CircuitCo/BeagleBone-DVI-D-with-Audio-RevA/BeagleBone-DVI-D-with-Audio-RevA-bom.xls

 |  | BeagleBone DVI-D with Audio | 2012-07-06
 |  | Rev A
ITM | QTY | REF DESIGNATIORS | PART | DESCRIPTION | MAN | PART # | COMMENT
1 | 25 | C7,C8,C9,C10,C11,C12,C13,C14,C15,C16,C18,C19,C20,C21,C22,C23,C79,C50,C51,C52,C54,C57,C60,C63,C78 | 0.1uF | Capacitor 0.1uF 16V 10% 0402 X7R | Kemet | C0402C104K4RACT
2 | 10 | C1,C2,C3,C4,C17,C55,C56,C58,C59,C62 | 10uF,0805 | CAP CER 10UF 10V Y5V 0805 | TDK | C2012Y5V1A106Z
3 | 2 | C46, C47 | 47uF | CAP CER 47UF 10V X5R 1210 | Murata | GRM32ER61A476KE20L
4 | 4 | C48,C49,C53,C61 | 47pF | CAP CER 47PF 50V C0G 5% 0402 | TDK | C1005C0G1H470J
5 | 4 | D1,D2,D3,D4 | PGB0010603MR | Ferrite Bead 150 Ohm 800mA | Steward | LI0805H151R-10
6 | 2 | D5,D6 | 598-8170-107F | LED Green SMD 20mA 2V 0805 | Dialight | 598-8170-107F
7 | 6 | FB1,FB2,FB3,FB6,FB7,FB8 | IND,MMZ1608R301A | FERRITE CHIP 300 OHM 500MA 0603 | TDK | MMZ1608R301A
8 | 1 | SW1 | 2 POS Dip Switch | SWITCH TAPE SEAL 2 POS SMD | CTS | 219-2MST
9 | 2 | P1,P2 | 2x23 HEADER FEMALE | .100 CL Dual Row- Straight Socket Strip- using .025" Sq. Pins | MLE | SSHQ-123-D-08-G-LF
 |  |  | 2x23 HEADER FEMALE | .100 CL Dual Row- Straight Socket Strip- using .025" Sq. Pins | MLE | SSHQ-123-D-08-F-LF
10 | 1 | P3 | 2x5 HEADER FEMALE | .100 CL Dual Row- Straight Socket Strip- using .025" Sq. Pins | MLE | SSHQ-105-D-08-G-LF
 |  |  | 2x5 HEADER FEMALE | .100 CL Dual Row- Straight Socket Strip- using .025" Sq. Pins | MLE | SSHQ-105-D-08-F-LF
11 | 1 | P4 | CONN_HDMI | CONN RCPT HDMI TYPE A R/A SMD | FCI | 10029449-001RLF
12 | 2 | P6,P7 | PHONOJACK STEREO-R | CONN JACK STEREO 3POS 3.5MM SMD | CUI | SJ1-3513-SMT
13 | 1 | Q1 | DMC56404 | TRANS NPN/NPN W/RES 50V SMINI6 | Panasonic | DMC564040R
14 | 1 | RT1 | PTC_RXEF010 | POLYSWITCH PTC RESET 0.1A | Polyswitch | RXEF010
15 | 20 | R16,R18,R20,R22,R24,R26,R28,R31,R33,R35,R36,R38,R40,R42,R44,R45,R58,R60,R62,R64, | 33402 | RES 33.0 OHM 1/16W 1% 0402 SMD | Yaego | RC0402FR-0733RL
16 | 20 | R37,R39,R41,R43,R52,R54,R59,R63,R65,R66,R69,R70,R74,R75,R76,R77,R78,R79,R80,R81 | 10402 | RES 10.0 OHM 1/16W 1% 0402 SMD | Yaego | RC0402FR-0710RL
17 | 4 | R86,R90,R94,R95,R123 | 10K | Resistor 10Kohm 1/16W 5% 0402 | Rohm | MCR01MZPJ103
18 | 1 | R87 | 510 | RES 510 OHM 1/16W 1% 0402 SMD | Yaego | RC0402FR-07510RL
19 | 2 | R88,R92 | 1.1K | RES 1.10K OHM 1/16W 1% 0402 SMD | Yageo | RC0402FR-071K1L
20 | 5 | R89,R93,R116,R117,R118 | 4.75K | RES 4.75K OHM 1/16W 1% 0402 SMD | Stackpole Electronics | RMCF0402FT4K75
21 | 3 | R108, R109, R110 | 33402 | RES 33.0 OHM 1/16W 1% 0402 SMD | Yaego | RC0805FR-0749R9L
22 | 1 | R112 | 28K | RES 28.0K OHM 1/16W 1% 0402 SMD | Yageo | RC0402FR-0728KL
23 | 1 | R113 | 56.2K | RES 56.2K OHM 1/16W 1% 0402 SMD | Yageo | CRCW040256K2FKED
24 | 1 | R111 | .1,0805 | RES .10 OHM 1/8W 5% 0805 | CTS | 73L3R10J
25 | 2 | R119,R120 | 470,5% | RES 470 OHM 1/10W 5% 0402 SMD | Panasonic | ERJ-2GEJ471X
26 | 2 | R121,R122 | 100K,1% | Resistor 100Kohm 1/16W 1% 0402 | Yageo | CRCW0402100KJNED
27 | 2 | R114,R115 | 5.6K | RES 5.6K OHM 1/16W 5% 0402 SMD | Yaego | RC0402JR-075K6L
28 | 2 | R130, R132 | 0 | Resistor Zero ohm Jumper 0402 | Yageo | RC0402JR-070RL
29 | 1 | U1 | 74AVC32t245 | IC BUS TRANSCVR 32BIT 96BGA | TI | SN74AVC32T245ZKER
30 | 1 | U2 | TFP410 | IC TRANSMITTER DIGITAL 64-HTQFP | TI | TFP410PAP
31 | 1 | U3 | TXS0102DCU | IC VOLT-LEVEL TRANSLATOR 8-US8 | TI | TXS0102DCUR
32 | 1 | U8 | CAT24C256W | IC EEPROM 256KBIT 400KHZ 8SOIC | ON | CAT24C256WI-G
33 | 1 | U6 | TLV320AIC3106 | IC STER AUD CODEC 32 BIT 48-VQFN | TI | TLV320AIC3106IRGZR
34 | 1 | U7 | TPS73701DRBR | IC REG LDO CAP FREE 8-SON | TI | TPS73701DRBR
35 | 1 | Y1 | 12MHz | OSCILLATOR 12.000 MHZ 3.3V SMD | Fox | FXO-HC735-12
 | DNI | R1,R107,R131,R133,C80,U9,C5,C6,C67,C68,C69,C70,C71, C72,C73,C74,C75,C76,C77,C81,R91,R96,R97,R98
