CircuitCo/BeagleBone-DVI-D-with-Audio-RevA/BeagleBone-DVI-D-with-Audio-RevA-schematic.pdf

# 08/14/2012 BBT

# DATE

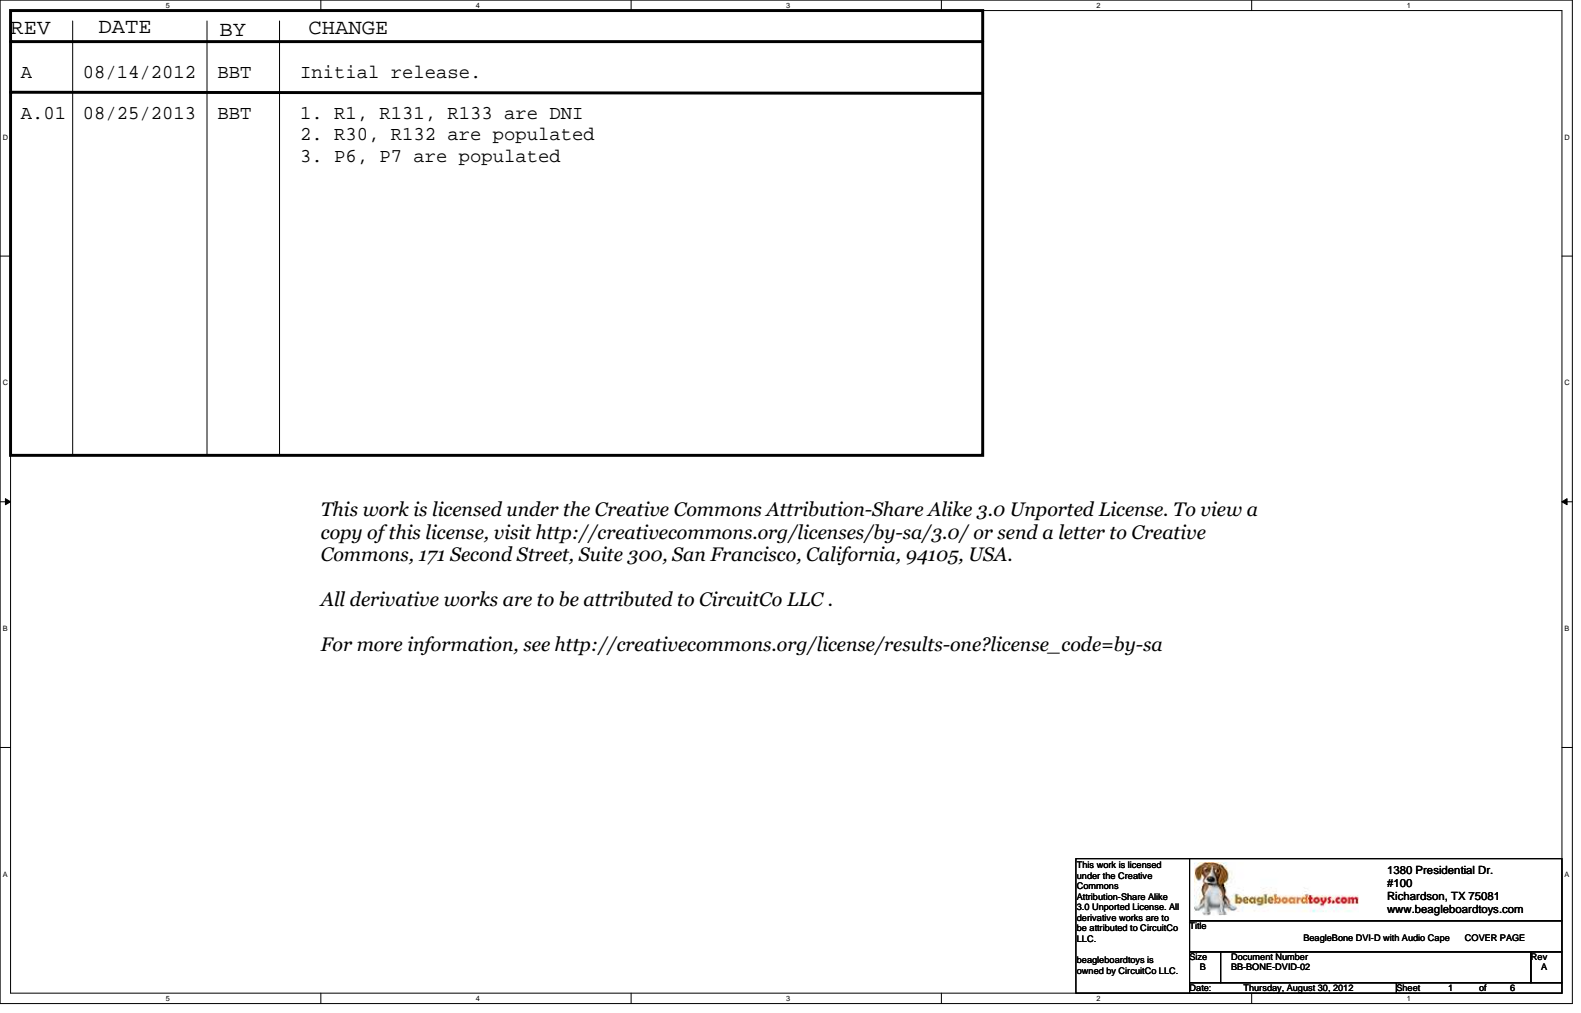
[picture p1: page 1]
REV; CHANGE; Initial release.; 1. R1, R131, R133 are DNI 08/25/2013; BBT; 2. R30, R132 are populated 3. P6, P7 are populated; Title; Size; Document Number; Rev; Date:; Sheet; BB-BONE-DVID-02; BeagleBone DVI-D with Audio Cape; COVER PAGE; Thursday, August 30, 2012

This work is licensed under the Creative Commons Attribution-Share Alike 3.0 Unported License. To view a
copy of this license, visit http://creativecommons.org/licenses/by-sa/3.0/ or send a letter to Creative
Commons, 171 Second Street, Suite 300, San Francisco, California, 94105, USA.

All derivative works are to be attributed to CircuitCo LLC .

For more information, see http://creativecommons.org/license/results-one?license_code=by-sa

This work is licensed
under the Creative
Commons
Attribution-Share Alike
3.0 Unported License. All
derivative works are to
be attributed to CircuitCo
LLC.

1380 Presidential Dr.
Richardson, TX 75081
www.beagleboardtoys.com

beagleboardtoys is
owned by CircuitCo LLC.

# CONN A IN

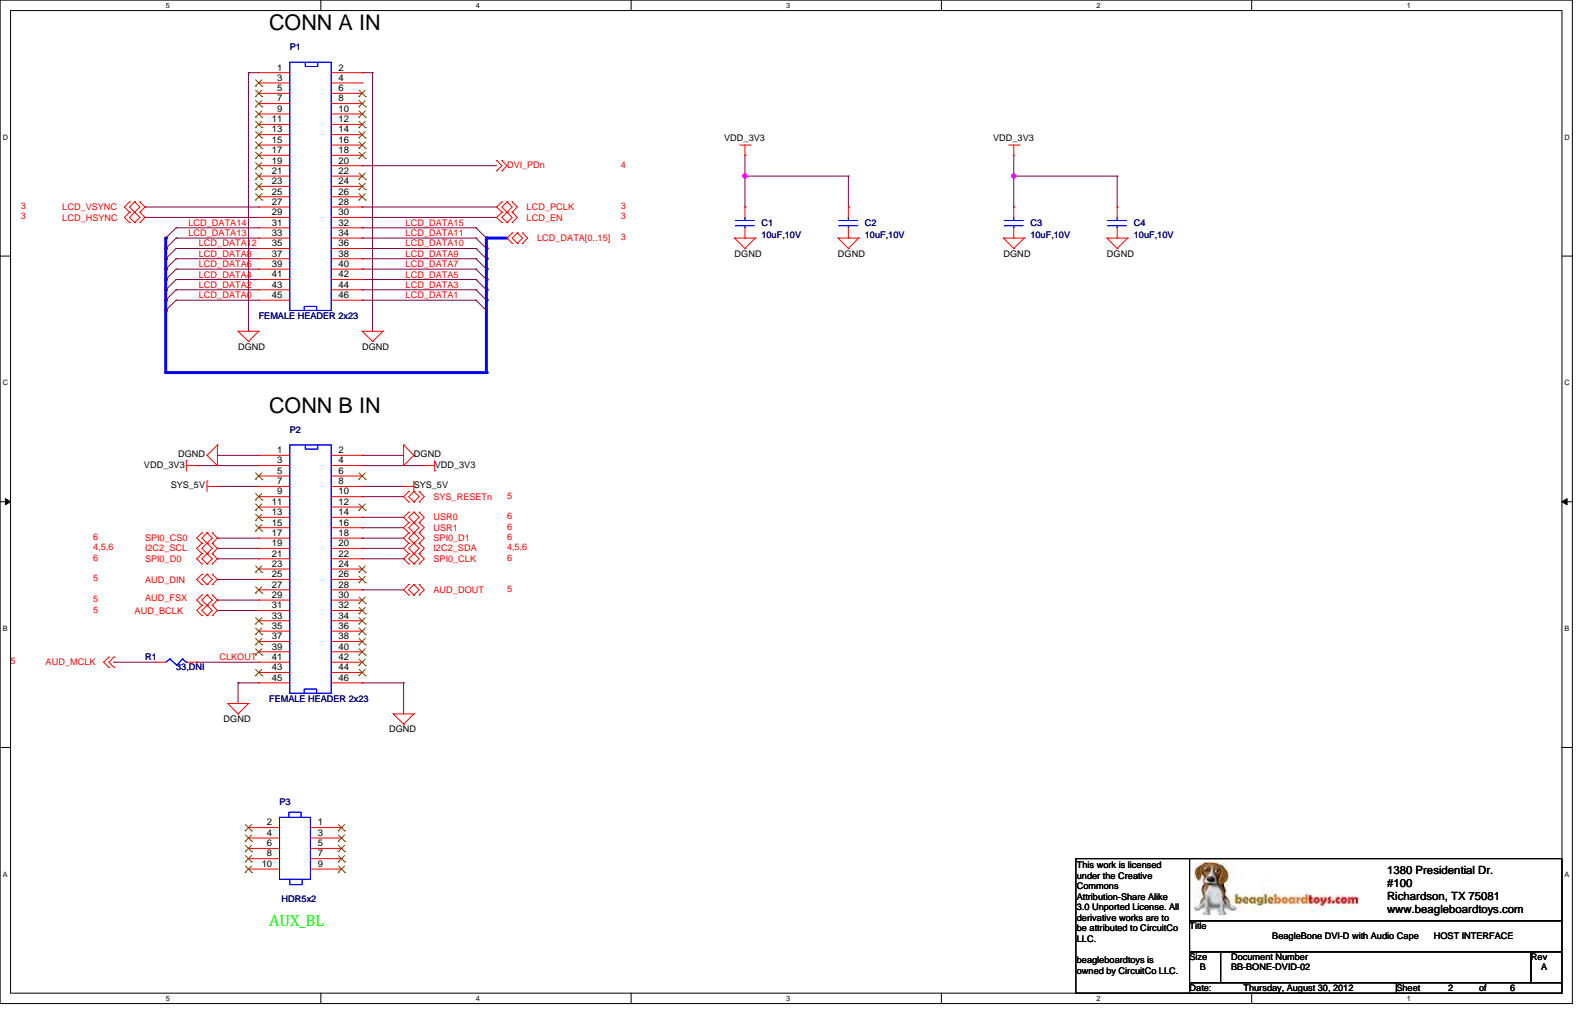
[picture p2: page 2]
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

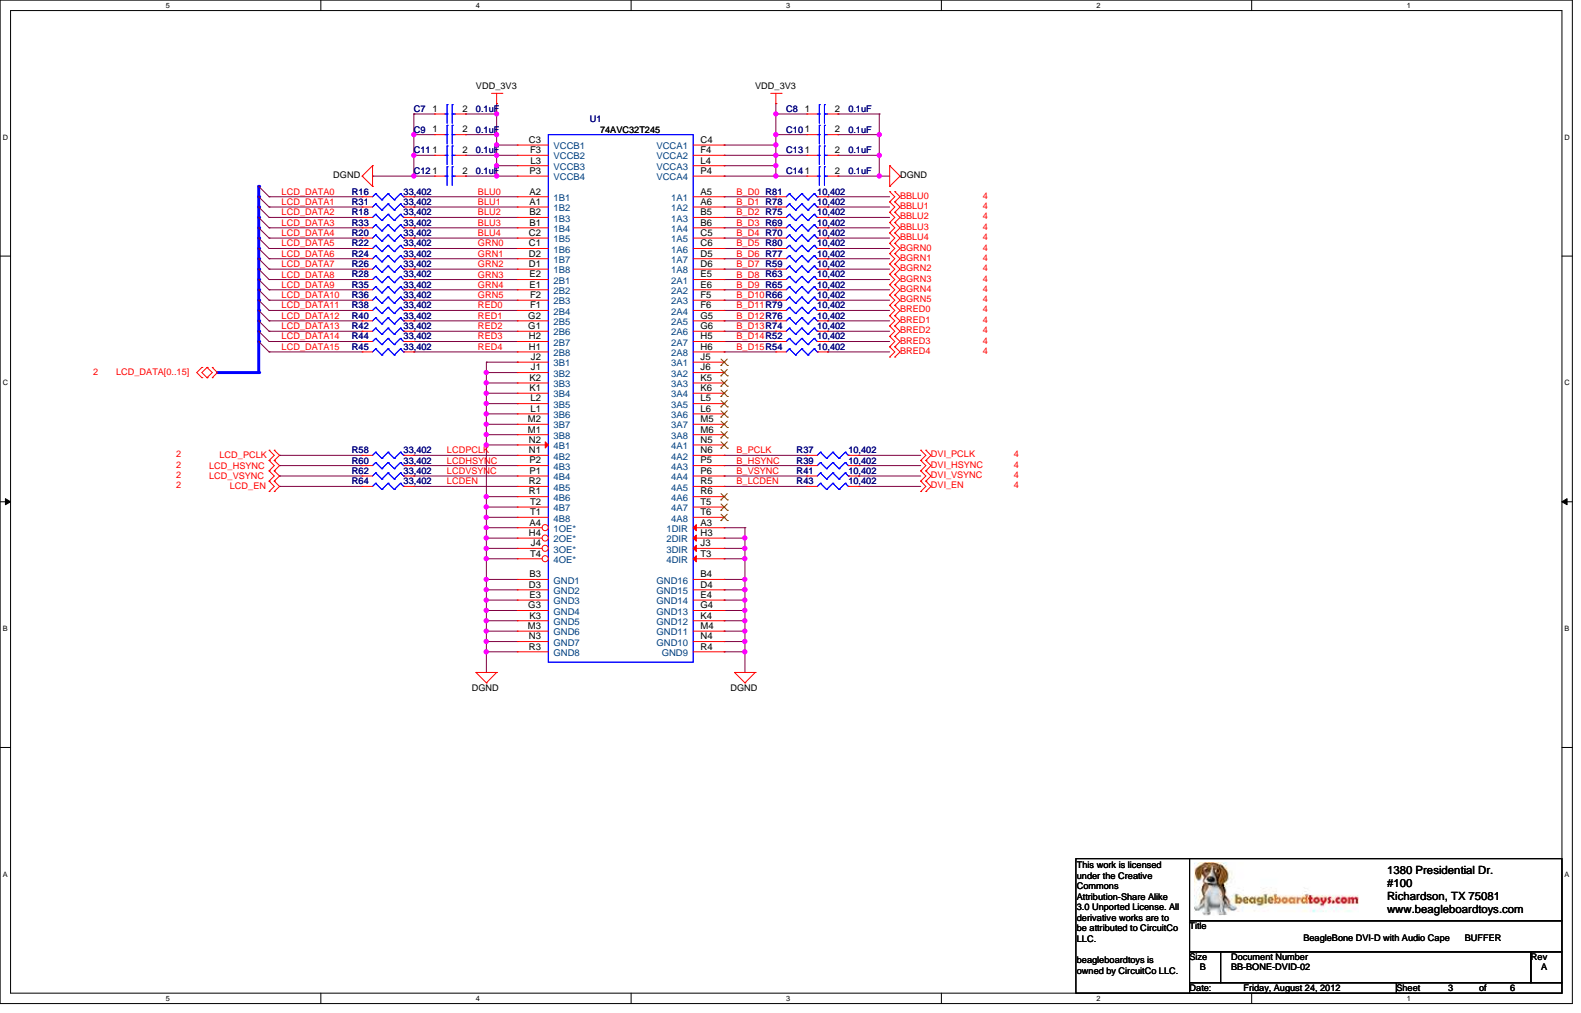
[picture p3: page 3]
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

# ISEL/RESET 13 PD 10 DVDD

t

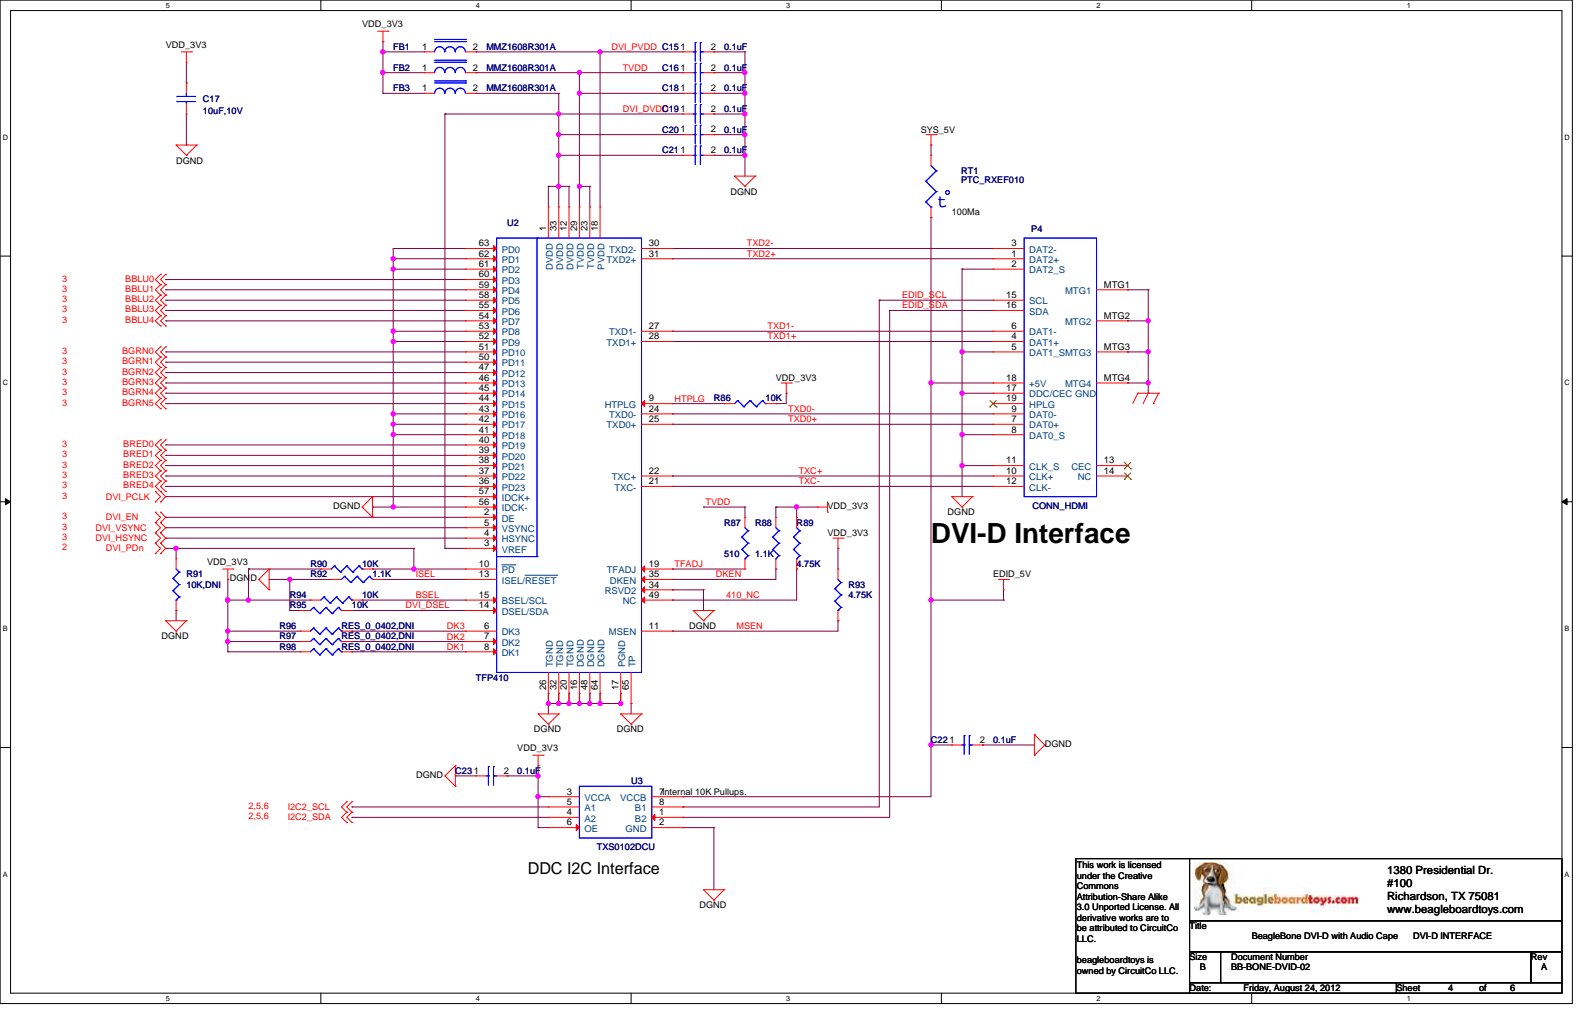
[picture p4: page 4]

DVI_DVDD C19 | 2 0.1uF 1

C20 | 2 0.1uF 1
C21 | 2 0.1uF 1

PVDD 18 TVDD 23 TVDD 29 DGND 48

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

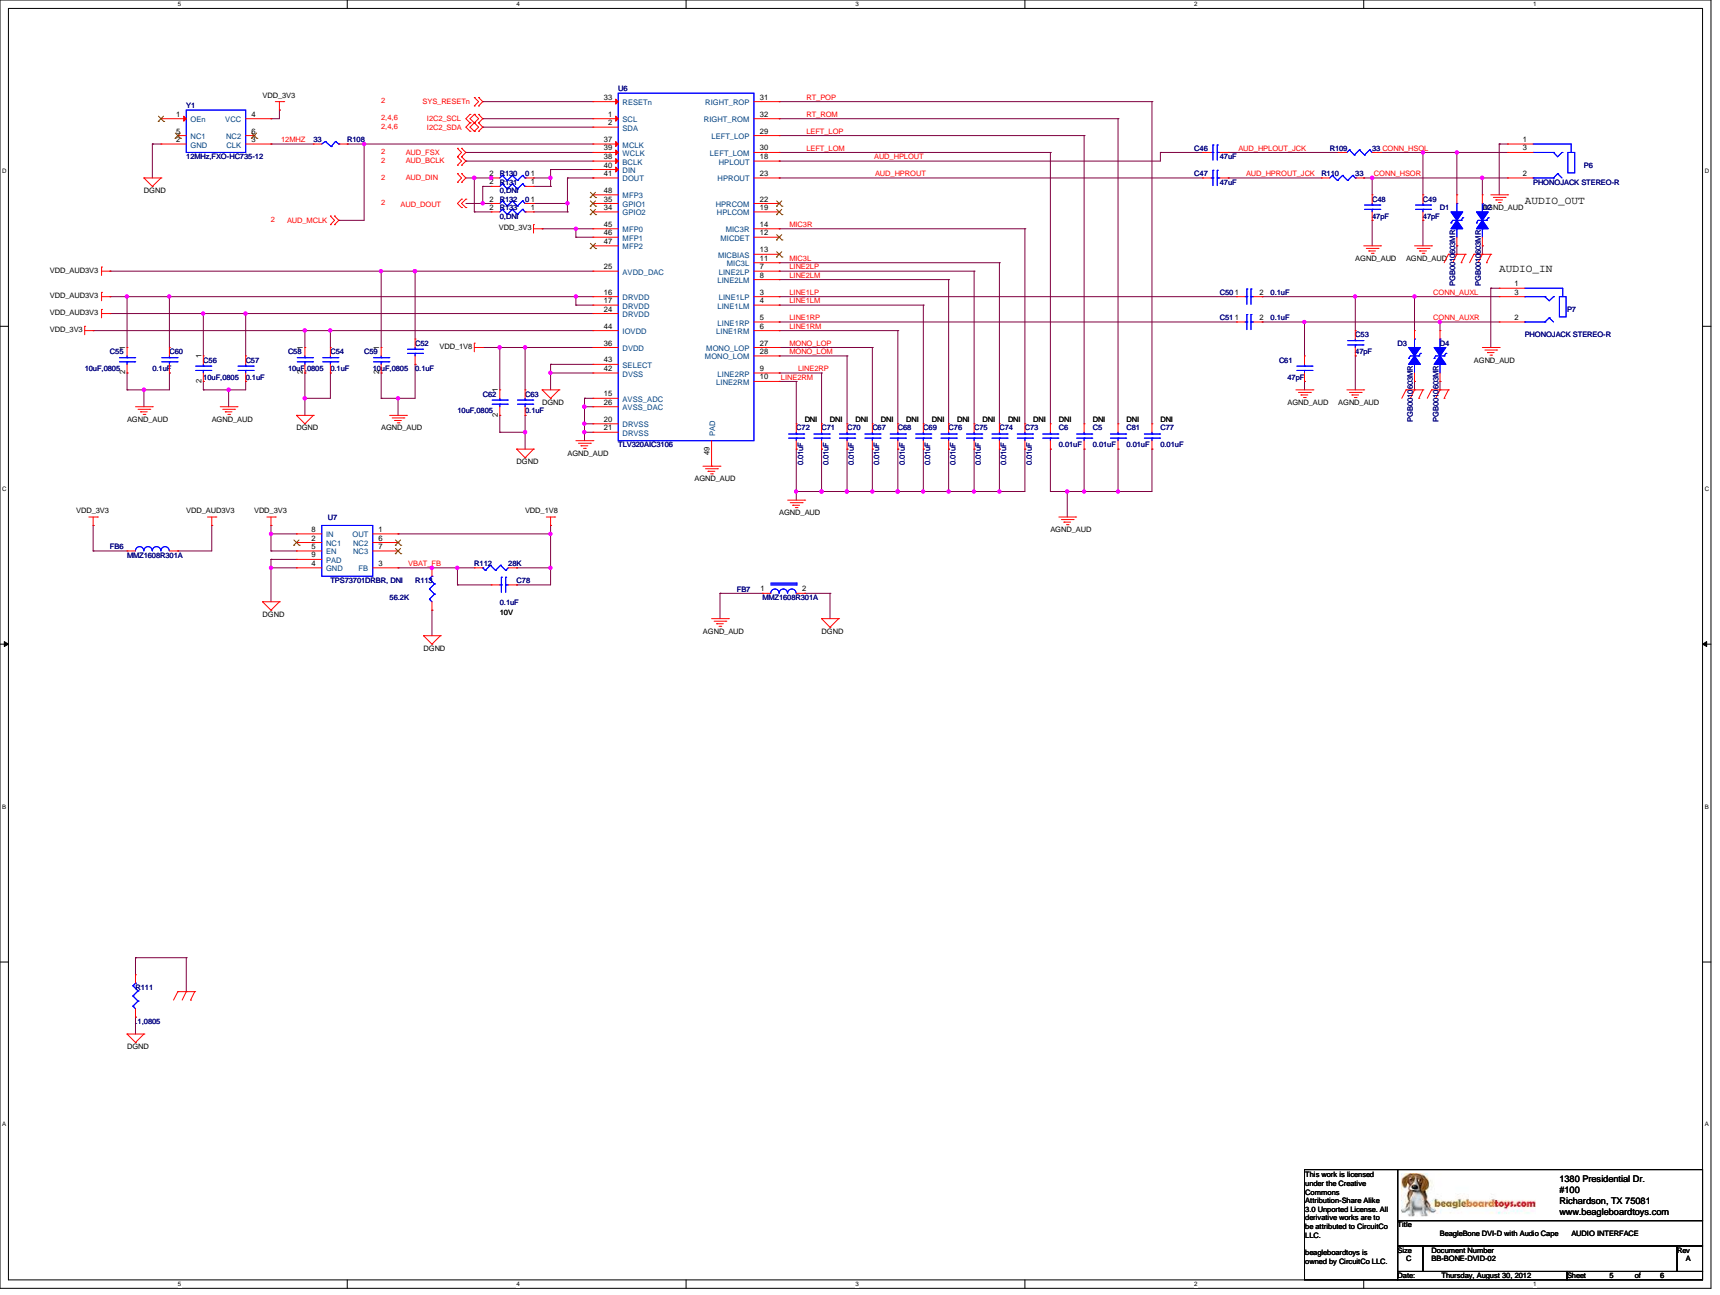
[picture p5: page 5]
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

## LED_COM

## SW1_A0

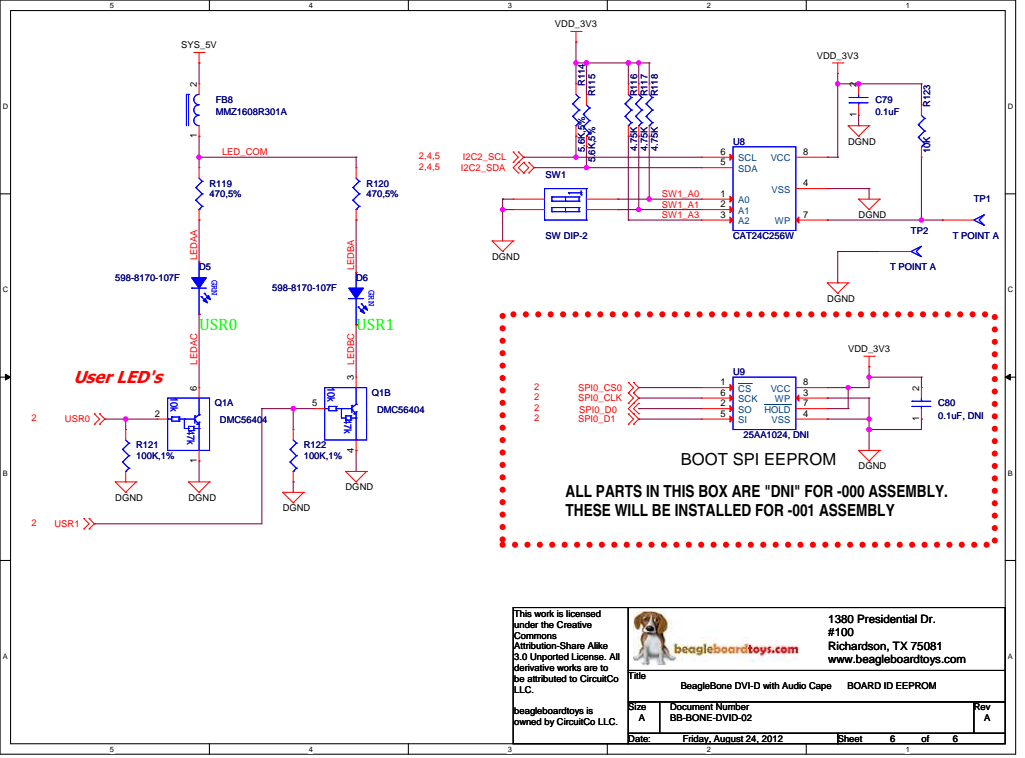
[picture p6: page 6]

ALL PARTS IN THIS BOX ARE "DNI" FOR -000 ASSEMBLY.
THESE WILL BE INSTALLED FOR -001 ASSEMBLY

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
