CircuitCo/BeagleBone-DVI-D-with-Audio-RevA/(list of files, drawings)

Other design files:
BeagleBone-DVI-D-with-Audio-RevA-schematic.dsn
