CircuitCo/BeagleBone-DVI-D-with-Audio-RevA/(commit log)

2012-08-30 rm schematic
    [BeagleBone-DVI-D-with-Audio-RevA-schematic.dsn]
2012-08-30 upd schematic
    [BeagleBone-DVI-D-with-Audio-RevA-schematic.dsn]
